amirabouraoui01-stack/EDU_RAK_2026/docs/GALERIE.md

# Fichiers visuels de la version retenue

[Accueil](../README.md)

- [Schéma complet A2 en PDF](../VeillePorte/veilleporte_complet.pdf)
- [Schéma KiCad modifiable](../VeillePorte/veilleporte_complet.kicad_pro)
- [Aperçu CST de l’antenne IFA à piste fine](../VeillePorte/cst/veilleporte_868_piste_basse.png)
- [Empreinte KiCad de l’antenne](../VeillePorte/footprints/VeillePorte_Antennes.pretty/IFA_868_CST_30x20_PisteFine.kicad_mod)

L’image CST montre la géométrie du modèle, pas le diagramme de rayonnement. L’export du farfield reste à faire. Aucun PCB VeillePorte final n’a encore été placé ou fabriqué.
