amirabouraoui01-stack/EDU_RAK_2026/archives/README.md

# Versions conservées

`2026-10-28_avant_reprise_40x60.zip` est la copie créée avant cette reprise. Elle contient le schéma, le projet, le PCB quatre couches précédent, le brouillon V2 deux couches, les tables et les bibliothèques locales. Les V2 ne sont plus mélangées au dossier du projet actif.

`v2_2couches_ancien_drc.json` conserve le rapport du brouillon deux couches. Cette ancienne version reste non validée.

Le projet actif à ouvrir est `../VeillePorte/veilleporte_complet.kicad_pro`.
