amirabouraoui01-stack/EDU_RAK_2026/VeillePorte/exports/vue_3d.png

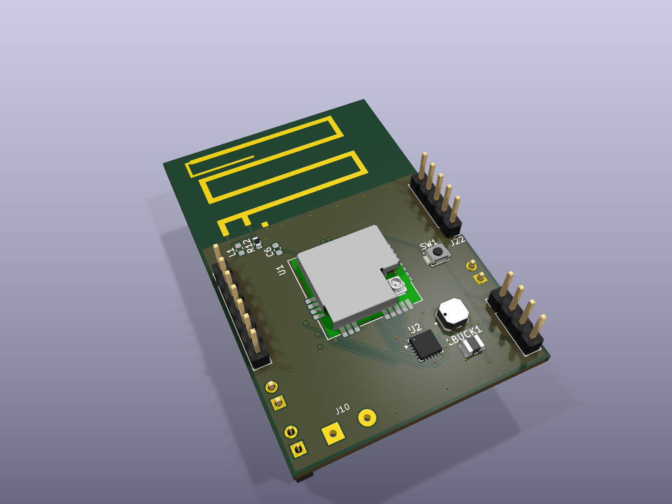
VeillePorte/exports/vue_3d.png
