amirabouraoui01-stack/EDU_RAK_2026/VeillePorte/exports/vue_dessous.png

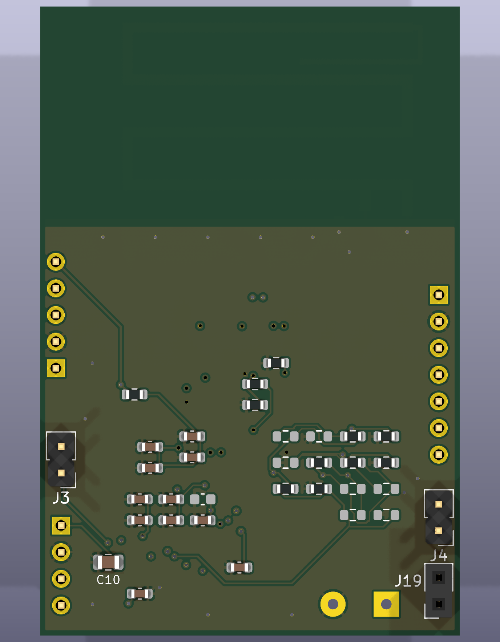
VeillePorte/exports/vue_dessous.png
