amirabouraoui01-stack/EDU_RAK_2026/VeillePorte/exports/vue_dessus.png

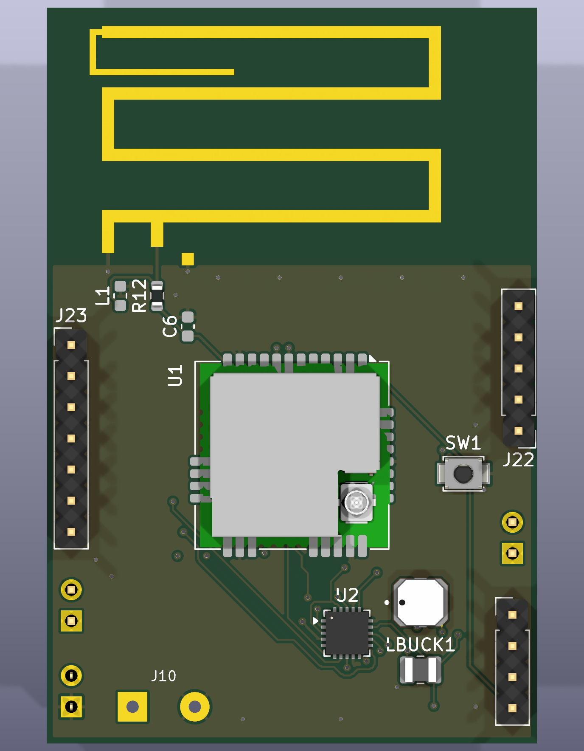
VeillePorte/exports/vue_dessus.png
