amirabouraoui01-stack/EDU_RAK_2026/VeillePorte/3dmodels/RAK3172.step

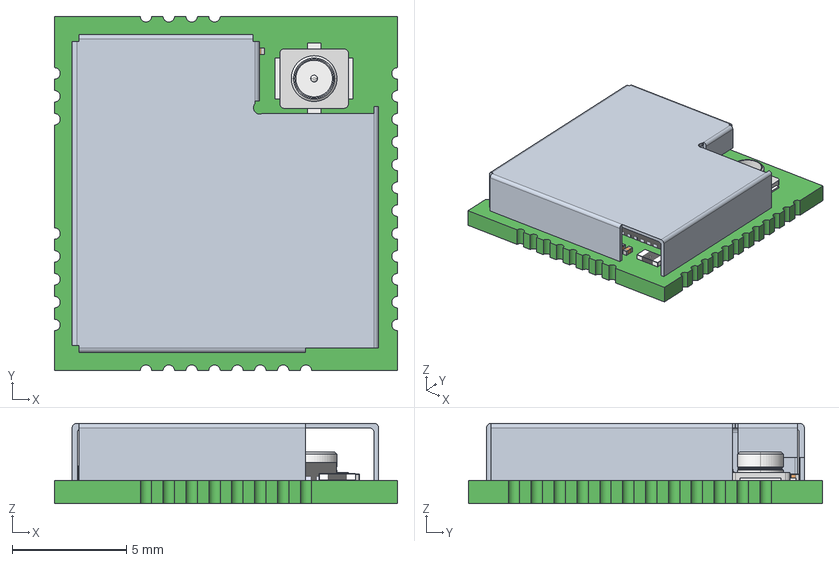
[picture p8: CAD file, 2026-10-28]
VeillePorte/3dmodels/RAK3172.step
15.0 x 15.5 x 3.51 mm
0201_SMD_Capacitor x 36
Extruded
R0201 x 7
RES_1005-0402 x 3
QFN48_7x7
NT2016SA
C0402 x 4
crystal_rtf2012
D030A-そ敖裔
