amirabouraoui01-stack/EDU_RAK_2026/VeillePorte/exports/veilleporte.step

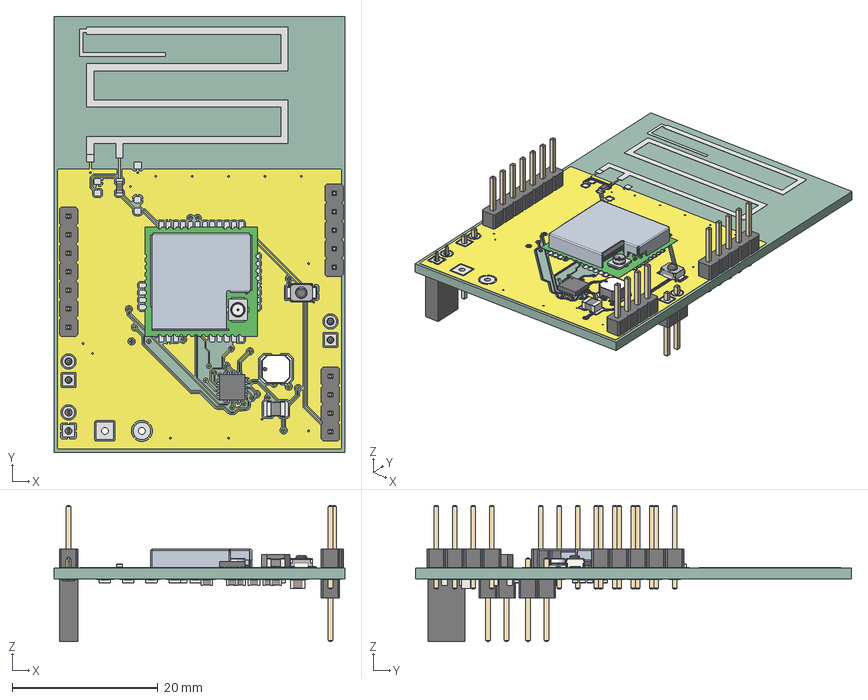
[picture p9: CAD file, 2026-10-28]
VeillePorte/exports/veilleporte.step
40.0 x 60.0 x 18.8 mm
SW_SPST_B3U-1000P
PinHeader_1x07_P254mm_Vertical
0201_SMD_Capacitor x 36
Extruded
R0201 x 7
RES_1005-0402 x 3
QFN48_7x7
NT2016SA
C0402 x 4
crystal_rtf2012
D030A-ǁ±θ
LPS4018-103MRC
R_0603_1608Metric x 12
L_1008_2520Metric
PinHeader_1x05_P254mm_Vertical
Texas_VQFN_RGR_20_1EP_35x35mm_Pitch05mm
PinHeader_1x04_P254mm_Vertical
C_0603_1608Metric x 11
C_0805_2012Metric
PinHeader_1x02_P254mm_Vertical x 2
PinSocket_1x02_P2.54mm_Vertical
veilleporte_complet_copper
veilleporte_complet_pad
veilleporte_complet_via
veilleporte_complet_PCB
