amirabouraoui01-stack/EDU_RAK_2026/VeillePorte/3dmodels/LPS4018-223MRC.step

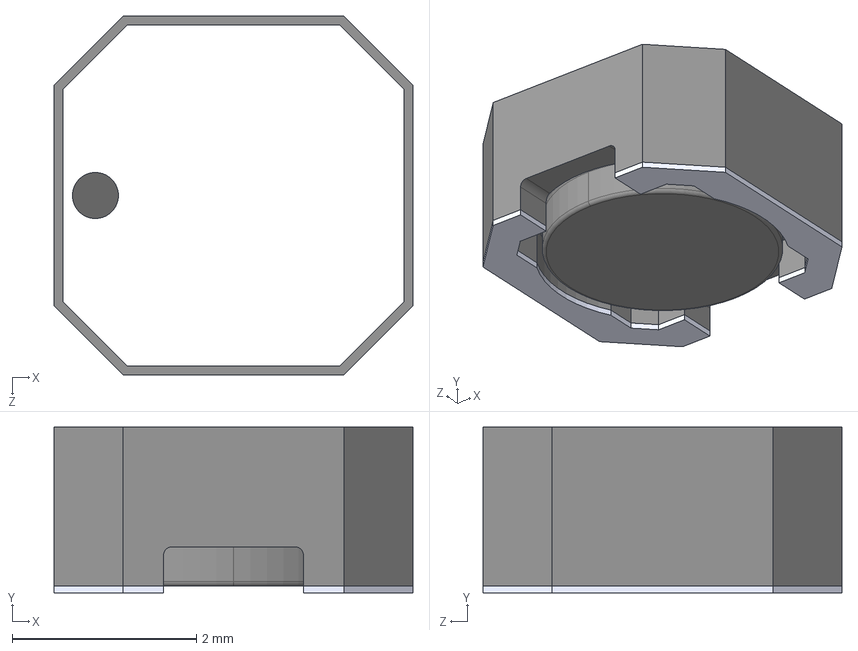
[picture p10: CAD file, 2026-10-14]
VeillePorte/3dmodels/LPS4018-223MRC.step
3.90 x 1.80 x 3.90 mm
