amirabouraoui01-stack/EDU_RAK_2026/VeillePorte/veilleporte_complet.pdf

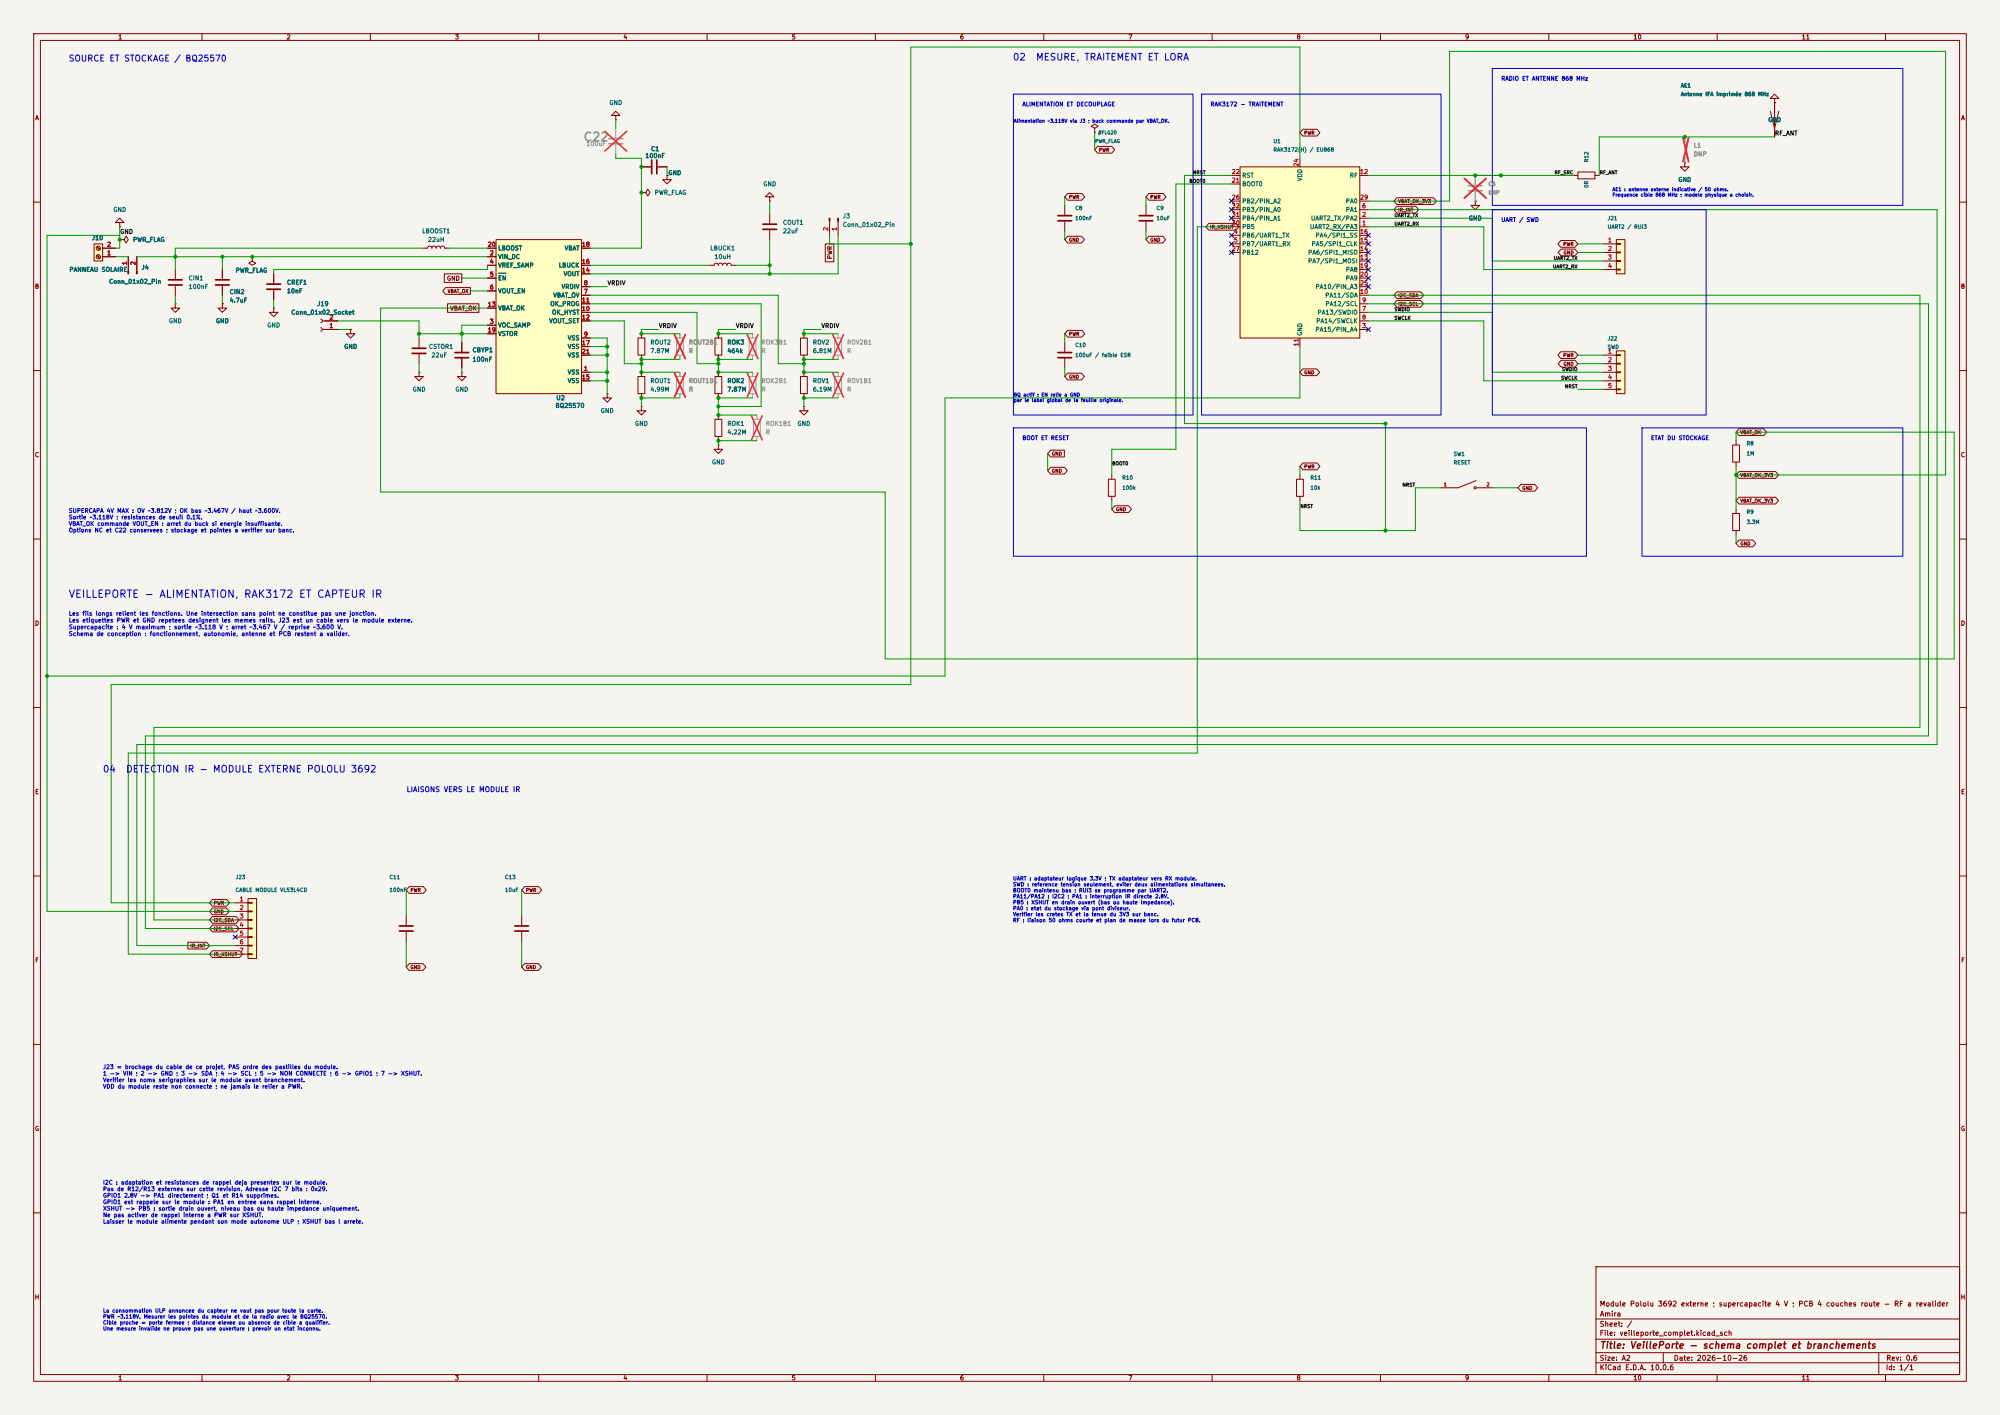
[picture p11: page 1]

RAK3172 - TRAITEMENT SOURCE ET STOCKAGE / BQ25570

02 MESURE, TRAITEMENT ET LORA

RADIO ET ANTENNE 868 MHz UART / SWD
20 BOOT0

Antenne IFA imprimée 868 MHzGND

ALIMENTATION ET DECOUPLAGE VEILLEPORTE - ALIMENTATION, RAK3172 ET CAPTEUR IR

6 PA8 1 UART2_TX/PA2

I2C_SDA

7 PA14/SWCLK | J22

BQ actif : EN relie a GND
par le label global de la feuille originale.

04 DETECTION IR - MODULE EXTERNE POLOLU 3692

LIAISONS VERS LE MODULE IR

UART : adaptateur logique 3.3V ; TX adaptateur vers RX module. SWD : reference tension seulement, eviter deux alimentations simultanees. BOOT0 maintenu bas ; RUI3 se programme par UART2. PA11/PA12 : I2C2 ; PA1 : interruption IR directe 2.8V. PB5 : XSHUT en drain ouvert (bas ou haute impedance). PA0 : etat du stockage via pont diviseur. Verifier les cretes TX et la tenue du 3V3 sur banc. RF : liaison 50 ohms courte et plan de masse lors du futur PCB.

I2C_SDA GND 3

J23 = brochage du cable de ce projet, PAS ordre des pastilles du module. 1 -> VIN ; 2 -> GND ; 3 -> SDA ; 4 -> SCL ; 5 -> NON CONNECTE ; 6 -> GPIO1 ; 7 -> XSHUT. Verifier les noms serigraphies sur le module avant branchement. VDD du module reste non connecte ; ne jamais le relier a PWR.

I2C : adaptation et resistances de rappel deja presentes sur le module. Pas de R12/R13 externes sur cette revision. Adresse I2C 7 bits : 0x29. GPIO1 2.8V -> PA1 directement ; Q1 et R14 supprimes. GPIO1 est rappele sur le module : PA1 en entree sans rappel interne. XSHUT -> PB5 : sortie drain ouvert, niveau bas ou haute impedance uniquement. Ne pas activer de rappel interne a PWR sur XSHUT. Laisser le module alimente pendant son mode autonome ULP ; XSHUT bas l arrete.

Module Pololu 3692 externe ; supercapacite 4 V ; PCB 4 couches route - RF a revalider
Amira
Sheet: /
File: veilleporte_complet.kicad_sch
Title: VeillePorte - schema complet et branchements

La consommation ULP annoncee du capteur ne vaut pas pour toute la carte. PWR ~3.118V. Mesurer les pointes du module et de la radio avec le BQ25570. Cible proche = porte fermee ; distance elevee ou absence de cible a qualifier. Une mesure invalide ne prouve pas une ouverture : prevoir un etat inconnu.

Size: A2 | Rev: 0.6
KiCad E.D.A. 10.0.6 | Id: 1/1
