amirabouraoui01-stack/EDU_RAK_2026/(list of files, drawings)

Other design files:
Collier_Chien/pcb_drc.json
VeillePorte/pcb_drc.json
