amirabouraoui01-stack/EDU_RAK_2026/VeillePorte/veilleporte_complet.kicad_pcb

## KiCad design VeillePorte/veilleporte_complet.kicad_pcb (2026-10-28)

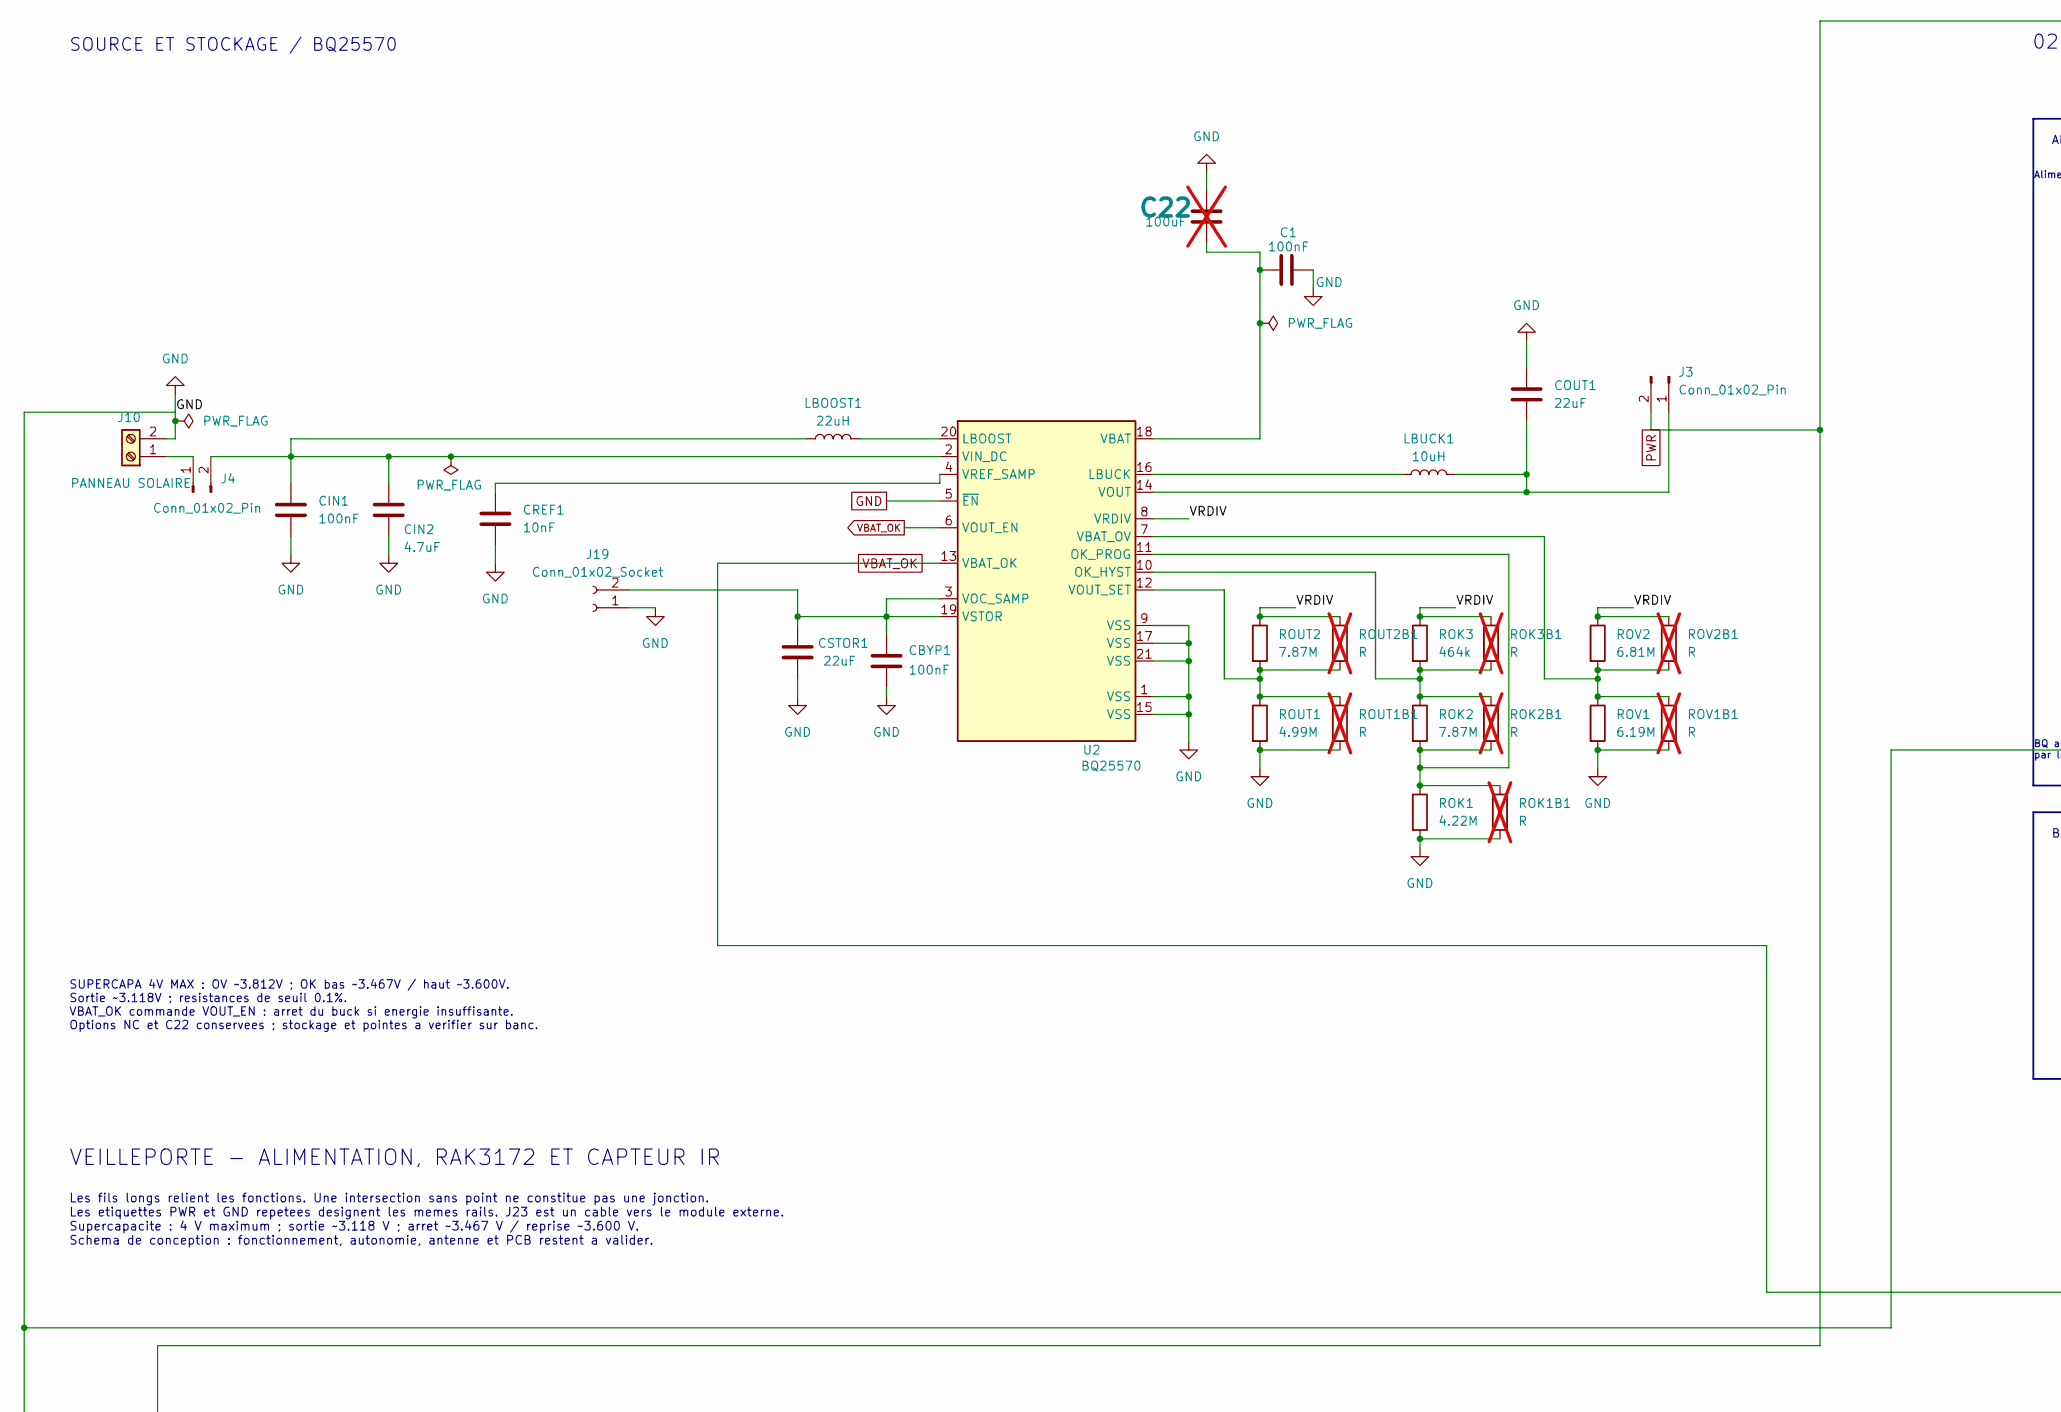
[picture p12: schematic veilleporte_complet.kicad_sch, VeillePorte - schema complet et branchements, part in row 1, column 1]

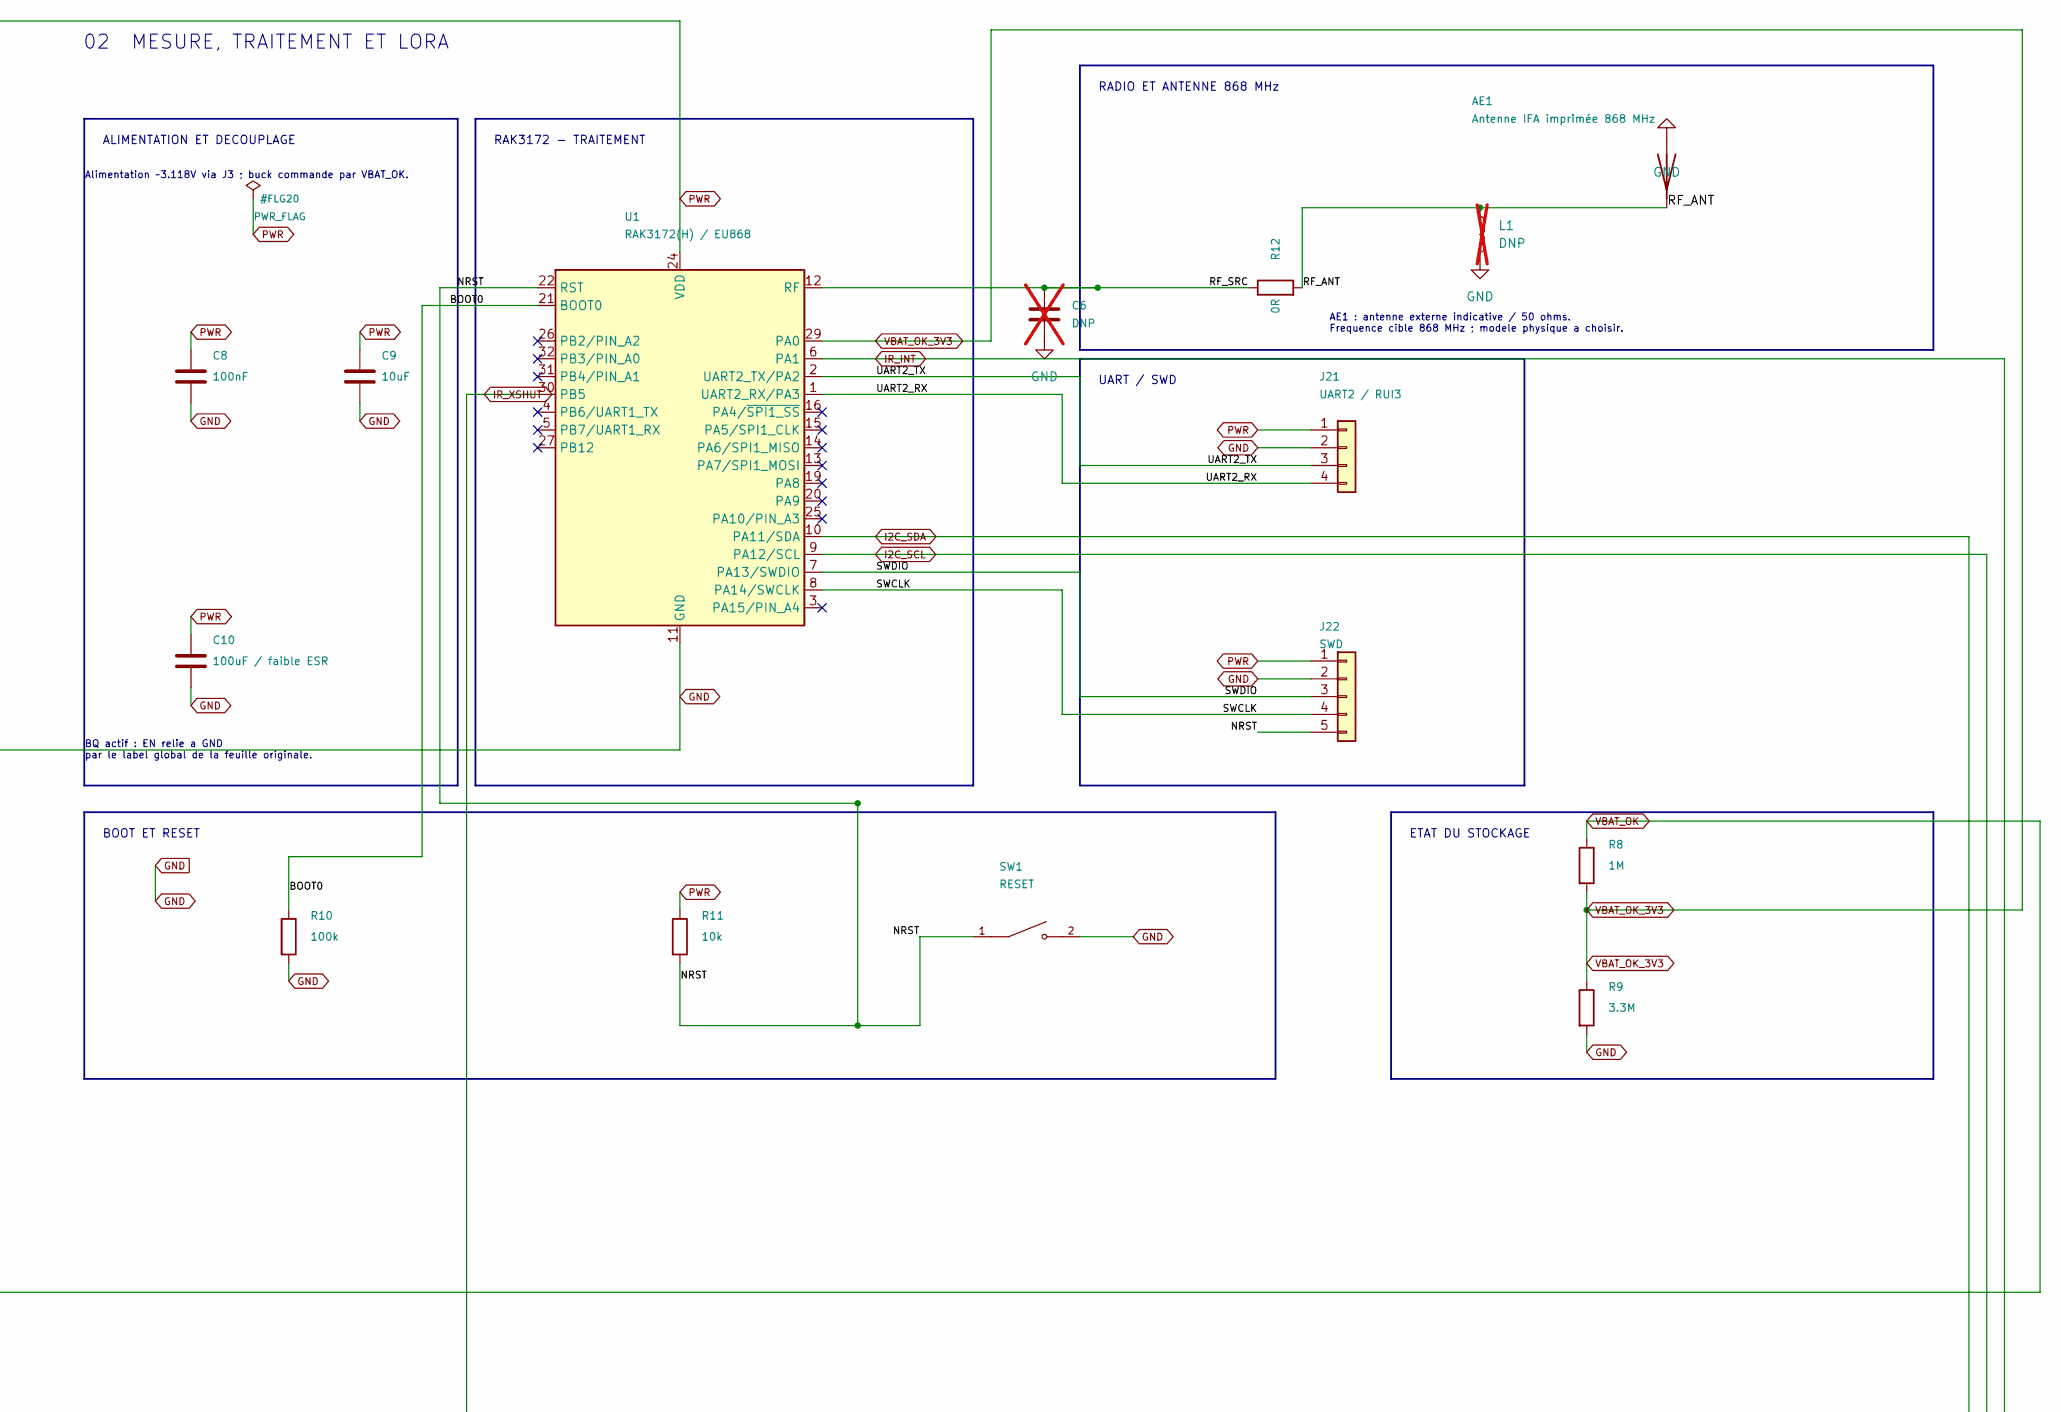
[picture p13: schematic veilleporte_complet.kicad_sch, VeillePorte - schema complet et branchements, part in row 1, column 2]

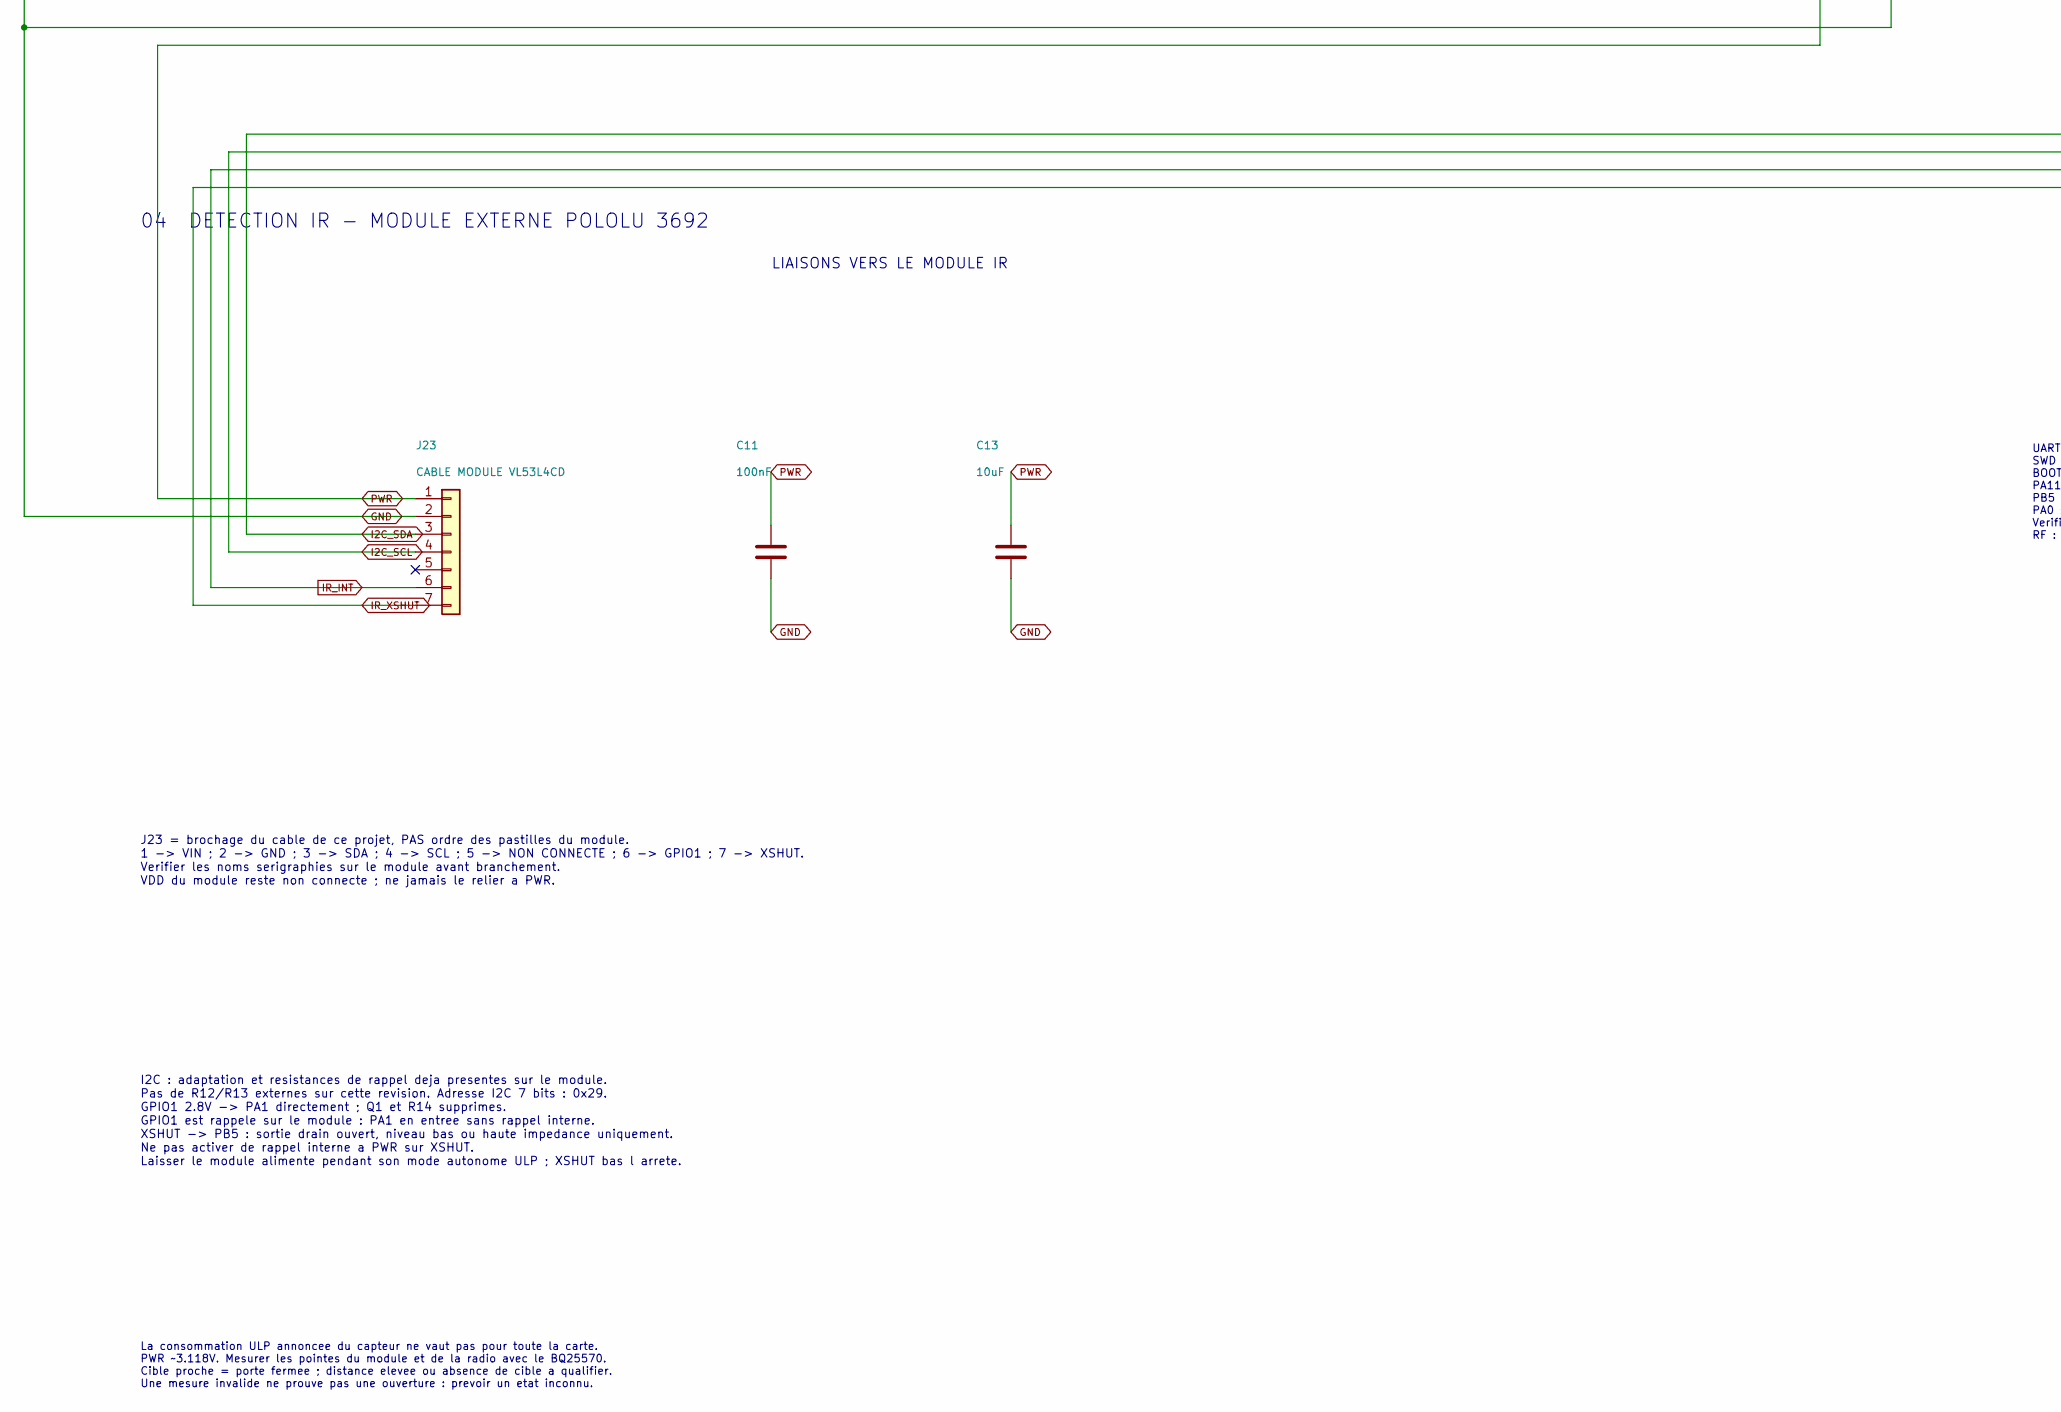
[picture p14: schematic veilleporte_complet.kicad_sch, VeillePorte - schema complet et branchements, part in row 2, column 1]

Parts:
AE1: Antenne IFA imprimée 868 MHz; IFA_868_CST_30x20_PisteFine
C1: 100nF; C_0603_1608Metric; LCSC C1591
C6: DNP; C_0603_1608Metric; not fitted
C8, C11: 100nF; C_0603_1608Metric
C9, C13: 10uF; C_0603_1608Metric
C10: 100uF / faible ESR; C_0805_2012Metric
C22: 100uF; C_0603_1608Metric; not fitted
CBYP1: 100nF; C_0603_1608Metric; LCSC C1591
CIN1: 100nF; C_0603_1608Metric; LCSC C1591
CIN2: 4.7uF; C_0603_1608Metric; LCSC C107368
COUT1: 22uF; C_0603_1608Metric; LCSC C2762594
CREF1: 10nF; C_0603_1608Metric; LCSC C1591
CSTOR1: 22uF; C_0603_1608Metric; LCSC C2762594
J3, J4: Conn_01x02_Pin; PinHeader_1x02_P2.54mm_Vertical; LCSC C3332353
J10: PANNEAU SOLAIRE; Solar_Wires_2x_D1.0_P5.08; LCSC C2683165
J19: Conn_01x02_Socket; PinSocket_1x02_P2.54mm_Vertical; LCSC C5372032
J21: UART2 / RUI3; PinHeader_1x04_P2.54mm_Vertical
J22: SWD; SWD_1x05_P2.54_VeillePorte
J23: CABLE MODULE VL53L4CD; PinHeader_1x07_P2.54mm_Vertical
L1: DNP; L_0603_1608Metric; not fitted
LBOOST1: 22uH; IND_LPS4018-223MRC; LCSC C5441602
LBUCK1: 10uH; L_1008_2520Metric; LCSC C237599
R8: 1M; R_0603_1608Metric
R9: 3.3M; R_0603_1608Metric
R10: 100k; R_0603_1608Metric
R11: 10k; R_0603_1608Metric
R12: 0R; R_0603_1608Metric
ROK1: 4.22M; R_0603_1608Metric; Tolerance 0.1%; LCSC C3009313
ROK1B1, ROK2B1, ROK3B1: R; R_0603_1608Metric; not fitted
ROK2: 7.87M; R_0603_1608Metric; Tolerance 0.1%; LCSC C482913
ROK3: 464k; R_0603_1608Metric; Tolerance 0.1%; LCSC C2930138
ROUT1: 4.99M; R_0603_1608Metric; Tolerance 0.1%; LCSC C2079741
ROUT1B1, ROUT2B1: R; R_0603_1608Metric; not fitted
ROUT2: 7.87M; R_0603_1608Metric; Tolerance 0.1%; LCSC C166757
ROV1: 6.19M; R_0603_1608Metric; Tolerance 0.1%; LCSC C422907
ROV1B1, ROV2B1: R; R_0603_1608Metric; not fitted
ROV2: 6.81M; R_0603_1608Metric; Tolerance 0.1%; LCSC C4087386
SW1: RESET; SW_SPST_B3U-1000P
U1: RAK3172(H) / EU868; RAK3172_VeillePorte
U2: BQ25570; BQ25570_VeillePorte; LCSC C506250

Connections:
/BOOT0: R10.1, U1.21 (BOOT0)
/NRST: J22.5, R11.2, SW1.1, U1.22 (RST)
/RF_ANT: AE1.1 (A), L1.1, R12.2
/RF_SRC: C6.1, R12.1, U1.12 (RF)
/SWCLK: J22.4, U1.8 (PA14/SWCLK)
/SWDIO: J22.3, U1.7 (PA13/SWDIO)
/UART2_RX: J21.4, U1.1 (UART2_RX/PA3)
/UART2_TX: J21.3, U1.2 (UART2_TX/PA2)
/VRDIV: ROK3.1, ROK3B1.1, ROUT2.1, ROUT2B1.1, ROV2.1, ROV2B1.1, U2.8 (VRDIV)
GND: AE1.2 (GND), C1.2, C6.2, C8.2, C9.2, C10.2, C11.2, C13.2, C22.2, CBYP1.2, CIN1.2, CIN2.2, COUT1.1, CREF1.2, CSTOR1.2, J10.2, J19.1, J21.2, J22.2, J23.2, L1.2, R9.2, R10.2, ROK1.2, ROK1B1.2, ROUT1.2, ROUT1B1.2, ROV1.2, ROV1B1.2, SW1.2, U1.11 (GND), U1.17 (GND), U1.18 (GND), U1.23 (GND), U1.28 (GND), U2.1 (VSS), U2.5 (~EN), U2.9 (VSS), U2.15 (VSS), U2.17 (VSS), U2.21 (VSS)
I2C_SCL: J23.4, U1.9 (PA12/SCL)
I2C_SDA: J23.3, U1.10 (PA11/SDA)
IR_INT: J23.6, U1.6 (PA1)
IR_XSHUT: J23.7, U1.30 (PB5)
unnamed: COUT1.2, J3.1, LBUCK1.2, U2.14 (VOUT)
unnamed: CIN1.1, CIN2.1, J4.2, LBOOST1.1, U2.2 (VIN_DC)
unnamed: J4.1, J10.1
unnamed: CBYP1.1, CSTOR1.1, J19.2, U2.3 (VOC_SAMP), U2.19 (VSTOR)
unnamed: LBOOST1.2, U2.20 (LBOOST)
unnamed: LBUCK1.1, U2.16 (LBUCK)
unnamed: ROK2.1, ROK2B1.1, ROK3.2, ROK3B1.2, U2.10 (OK_HYST)
unnamed: ROK1.1, ROK1B1.1, ROK2.2, ROK2B1.2, U2.11 (OK_PROG)
unnamed: C1.1, C22.1, U2.18 (VBAT)
unnamed: ROV1.1, ROV1B1.1, ROV2.2, ROV2B1.2, U2.7 (VBAT_OV)
unnamed: ROUT1.1, ROUT1B1.1, ROUT2.2, ROUT2B1.2, U2.12 (VOUT_SET)
unnamed: CREF1.1, U2.4 (VREF_SAMP)
PWR: C8.1, C9.1, C10.1, C11.1, C13.1, J3.2, J21.1, J22.1, J23.1, R11.1, U1.24 (VDD)
VBAT_OK: R8.1, U2.6 (VOUT_EN), U2.13 (VBAT_OK)
VBAT_OK_3V3: R8.2, R9.1, U1.29 (PA0)

Notes on the sheet:
BQ actif : EN relie a GND par le label global de la feuille originale.
ETAT DU STOCKAGE
Les fils longs relient les fonctions. Une intersection sans point ne constitue pas une jonction. Les etiquettes PWR et GND repetees designent les memes rails. J23 est un cable vers le module externe. Supercapacite : 4 V maximum ; sortie ~3.118 V ; arret ~3.467 V / reprise ~3.600 V. Schema de concep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
UART : adaptateur logique 3.3V ; TX adaptateur vers RX module. SWD : reference tension seulement, eviter deux alimentations simultanees. BOOT0 maintenu bas ; RUI3 se programme par UART2. PA11/PA12 : I2C2 ; PA1 : interruption IR directe 2.8V. PB5 : XSHUT en drain ouvert (bas ou haute impedance). PA0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
SUPERCAPA 4V MAX : OV ~3.812V ; OK bas ~3.467V / haut ~3.600V. Sortie ~3.118V ; resistances de seuil 0.1%. VBAT_OK commande VOUT_EN : arret du buck si energie insuffisante. Options NC et C22 conservees ; stockage et pointes a verifier sur banc.
BOOT ET RESET
AE1 : antenne externe indicative / 50 ohms. Frequence cible 868 MHz ; modele physique a choisir.
Alimentation ~3.118V via J3 ; buck commande par VBAT_OK.
UART / SWD
02 MESURE, TRAITEMENT ET LORA
LIAISONS VERS LE MODULE IR
RAK3172 - TRAITEMENT
ALIMENTATION ET DECOUPLAGE
La consommation ULP annoncee du capteur ne vaut pas pour toute la carte. PWR ~3.118V. Mesurer les pointes du module et de la radio avec le BQ25570. Cible proche = porte fermee ; distance elevee ou absence de cible a qualifier. Une mesure invalide ne prouve pas une ouverture : prevoir un etat inconn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
J23 = brochage du cable de ce projet, PAS ordre des pastilles du module. 1 -> VIN ; 2 -> GND ; 3 -> SDA ; 4 -> SCL ; 5 -> NON CONNECTE ; 6 -> GPIO1 ; 7 -> XSHUT. Verifier les noms serigraphies sur le module avant branchement. VDD du module reste non connecte ; ne jamais le relier a PWR.
I2C : adaptation et resistances de rappel deja presentes sur le module. Pas de R12/R13 externes sur cette revision. Adresse I2C 7 bits : 0x29. GPIO1 2.8V -> PA1 directement ; Q1 et R14 supprimes. GPIO1 est rappele sur le module : PA1 en entree sans rappel interne. XSHUT -> PB5 : sortie drain ouvert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
RADIO ET ANTENNE 868 MHz
SOURCE ET STOCKAGE / BQ25570
VEILLEPORTE - ALIMENTATION, RAK3172 ET CAPTEUR IR
04 DETECTION IR - MODULE EXTERNE POLOLU 3692

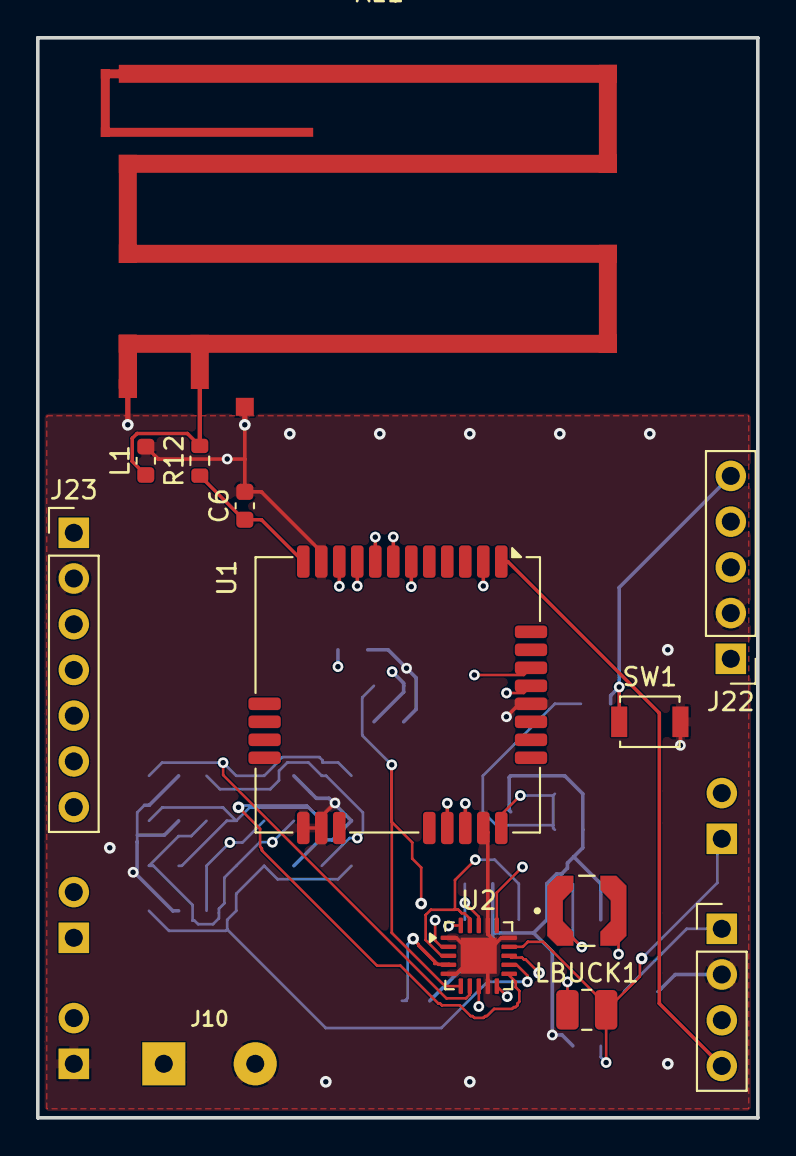
[picture p15: board veilleporte_complet.kicad_pcb from above]

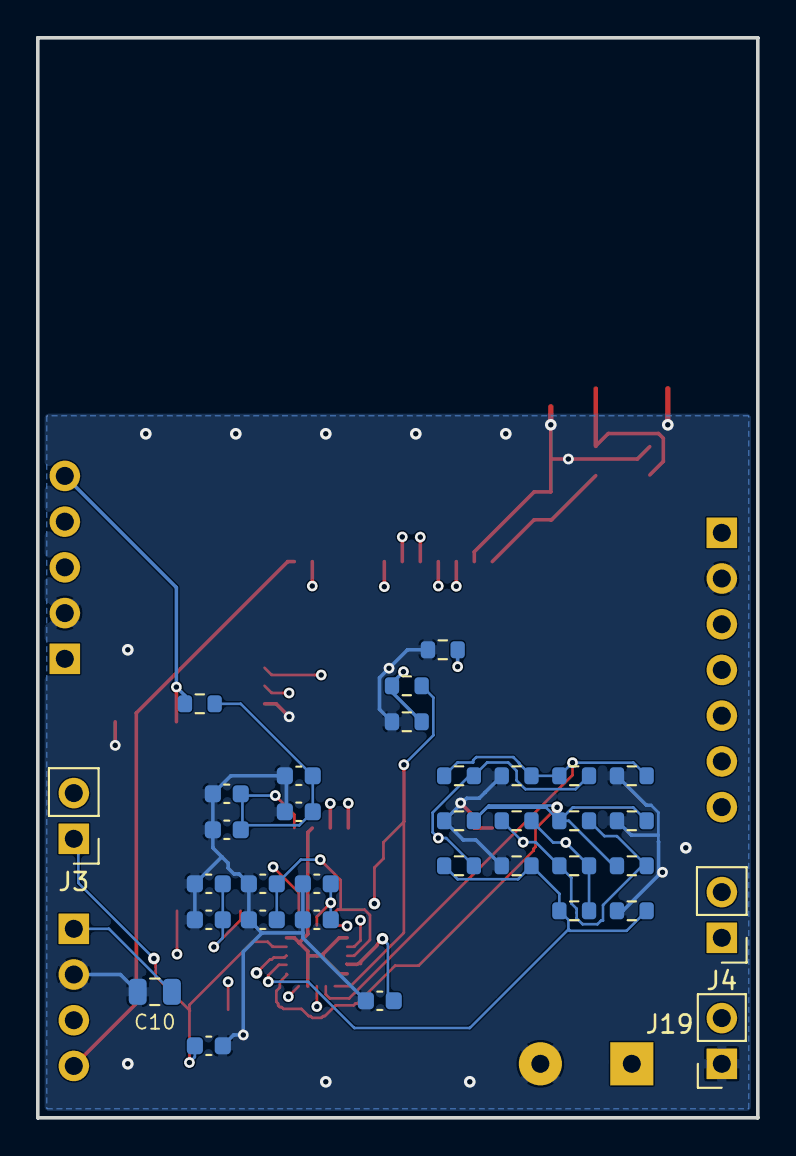
[picture p16: board veilleporte_complet.kicad_pcb from below]

Board: 4 copper layers, 40.0 x 60.0 mm, 47 parts (34 on the bottom side), 29 nets.
