amirabouraoui01-stack/EDU_RAK_2026/(commit log)

2026-10-14 Ajoute le schema KiCad du collier chien RAK3172 BQ25570 LIS2HH12
    [accelerometre.kicad_sch, alimentation.kicad_sch, collier_chien.kicad_sch, rak3172.kicad_sch]
2026-10-14 Restaure la feuille BQ25570 EDU RAK a identique
    [accelerometre.kicad_sch, alimentation.kicad_sch, collier_chien.kicad_sch, rak3172.kicad_sch]
2026-10-14 Personnalise le depot du collier et verifie le schema avec antenne 868 MHz
    [accelerometre.kicad_sch, bom.csv, bq25505(70_Design_Help_V1_3.xlsx, collier_chien.kicad_sch, designators.csv, positions.csv, rak3172.kicad_sch]
2026-10-14 Importe empreinte et modele 3D LPS4018-223MRC pour LBOOST1
    [LPS4018-223MRC.step]
2026-10-14 Ajoute PCB preliminaire 60x30 mm et 47 composants du schema
    [collier_chien.kicad_pcb, pcb_drc.json]
2026-10-14 Documente le placement preliminaire du PCB dans accueil
2026-10-14 Route le collier 60x30 sur deux couches avec plan de masse et retour RF protege
    [collier_chien.kicad_pcb, pcb_drc.json]
2026-10-14 Normalise la presentation des SVG exportes
2026-10-26 Adapte le projet a ColisCare pour le suivi des colis fragiles
2026-10-26 Definit le comportement et les essais de ColisCare V1
2026-10-26 Presente VeillePorte pour accompagner les personnes atteintes d Alzheimer
2026-10-26 Renomme le projet KiCad et ses fichiers en VeillePorte
    [LPS4018-223MRC.step, accelerometre.kicad_sch, alimentation.kicad_sch, collier_chien.kicad_sch, pcb_drc.json, rak3172.kicad_sch, veilleporte.kicad_pcb, veilleporte.kicad_sch]
2026-10-26 Remplace le LIS2HH12 par le raccordement IR VL53L4CD Pololu 3692
    [accelerometre.kicad_sch, capteur_ir.kicad_sch, pcb_drc.json, rak3172.kicad_sch, veilleporte.kicad_pcb, veilleporte.kicad_sch]
2026-10-26 Normalise les fins de ligne du schema IR
    [capteur_ir.kicad_sch]
2026-10-26 Regle le BQ25570 pour supercapacite 4V et structure la feuille RAK
    [alimentation.kicad_sch, capteur_ir.kicad_sch, rak3172.kicad_sch, veilleporte.kicad_sch]
2026-10-26 Reunit VeillePorte sur une page A2 avec les branchements visibles
    [veilleporte_complet.kicad_sch]
2026-10-26 Remplace la plaque de l antenne par un retour de piste fin
2026-10-26 Lie l antenne IFA a KiCad
    [veilleporte_complet.kicad_sch]
2026-10-27 Nettoie le dépôt autour de la version finale
    [alimentation.kicad_sch, capteur_ir.kicad_sch, pcb_drc.json, rak3172.kicad_sch, veilleporte.kicad_pcb, veilleporte.kicad_sch]
2026-10-27 Ajoute le PCB avec l antenne CST
    [pcb_drc.json, veilleporte.kicad_pcb]
2026-10-27 Ajoute contour et cuivre quatre couches
    [pcb_drc.json, veilleporte.kicad_pcb]
2026-10-27 Place le RAK au centre et les connecteurs au pourtour
    [pcb_drc.json, veilleporte.kicad_pcb]
2026-10-27 Ajoute adaptation RF 868 MHz avec shunts DNP
    [pcb_drc.json, veilleporte.kicad_pcb, veilleporte_complet.kicad_sch]
2026-10-27 Corrige le branchement RF de C6 et les masses
    [veilleporte_complet.kicad_sch]
2026-10-27 Reroute la branche RF autour de C6
    [veilleporte_complet.kicad_sch]
2026-10-28 Raccorde C6 en shunt sur RF
    [veilleporte_complet.kicad_sch]
2026-10-28 Nettoie et unifie le projet KiCad VeillePorte
    [veilleporte_complet.kicad_pcb, veilleporte_complet.kicad_sch]
2026-10-28 Redimensionne le PCB VeillePorte en 40x60 mm
    [pcb_drc.json, veilleporte_complet.kicad_pcb]
2026-10-28 Route first VeillePorte PCB signals
    [pcb_drc.json, veilleporte_complet.kicad_pcb]
2026-10-28 Reprendre implantation PCB quatre couches avant routage
    [pcb_drc.json, veilleporte_complet.kicad_pcb]
2026-10-28 Router VeillePorte en quatre couches avec GND In2 et exports 3D
    [RAK3172.step, audit_pistes.csv, pcb_drc.json, veilleporte.step, veilleporte_complet.kicad_pcb, veilleporte_complet.kicad_sch]
